Hikaru-Su/uC_easiri/README.md

# uC_easiri
## can通信系エアシリ制御ボード
1. 電源が切り離されているため、電磁弁用の電源が必要。
3. 12V時に電磁弁に印加される電流が160mAほどだったため8個同時に動かす場合、1Aを超えるため電源を分けた。<br>

|MCUピン|エアシリ番号|
|---|---|
|pin9|es5|
|pin10|es6|
|pin11|es7|
|pin12|es8|
|pin13|es1|
|pin14|es2|
|pin15|es3|
|pin18|es4|
