Hikaru-Su/uC_easiri/エアシリ部品リスト/エアシリ部品リスト.tex

\documentclass[12pt,a4paper,dvipdfmx]{ujarticle}
\usepackage[top = 20truemm, bottom = 20truemm, left = 15truemm , right = 15truemm]{geometry}
\usepackage[dvipdfmx]{graphicx}
\usepackage{here}
\usepackage[dvipdfmx]{hyperref}
\usepackage{pxjahyper}
\hypersetup{
	bookmarksnumbered = true,
	colorlinks = true,
	setpagesize = false,
	linkcolor = blue,
	urlcolor = blue
}
\title{エアシリ基板部品リスト}
\author{小野澤颯}
\begin{document}
\maketitle
\begin{tabular}{ccccl}
	\hline
	部品名 &必要個数& 買う場所 & 金額 & 備考\\
	\hline
	stdc14pin &1&\href{https://www.digikey.jp/product-detail/ja/samtec-inc/FTSH-107-01-L-D-K/612-FTSH-107-01-L-D-K-ND/6693516}{digi-key}&375&\\
	\hline
	soic8 mcp2562&1& \href{https://www.digikey.jp/product-detail/ja/microchip-technology/MCP2562T-E-SN/MCP2562T-E-SNCT-ND/5011025}{digikey}&101 & rsとかでも買える\\
	\hline
	tlp290 4回路 & 2 & \href{https://jp.rs-online.com/web/p/products/8851083/}{rs}&68.50&\\
	\hline
	tc4011bft &2&\href{https://jp.rs-online.com/web/p/products/6634283/}{rs}&50.40&\\
	\hline
	2sc5964 &1&\href{https://jp.rs-online.com/web/p/products/7740746/}{rs}&42.10&\\
	\hline
	njm11100f1 &1&\href{https://akizukidenshi.com/catalog/g/gI-06655/}{秋月電子通商}&150&\\
	\hline
	12MHz セラロック &1&\href{https://akizukidenshi.com/catalog/g/gP-14322/}{秋月電子通商}&200&\\
	\hline
	表面実装タクトスイッチ&1&\href{https://akizukidenshi.com/catalog/g/gP-14888/}{秋月電子通商}&110&\\
	\hline
	チップled & 8 & \href{https://akizukidenshi.com/catalog/g/gI-11880/}{秋月電子通商}&100 &色はなんでもいい\\
	\hline
	フルカラーled & 1 & \href{https://akizukidenshi.com/catalog/g/gI-12726/}{秋月電子通商}&100 &\\
	\hline
	抵抗内蔵led & 1 & \href{https://akizukidenshi.com/catalog/g/gI-06252/}{秋月電子通商}&200&色はなんでもいい\\
	\hline
	10pinボックスヘッダ & 1 & \href{https://akizukidenshi.com/catalog/g/gC-13178/}{秋月電子通商}&25 &\\
	\hline
	stm32f303k8 &1&\href{https://akizukidenshi.com/catalog/g/gI-10790/}{秋月電子通商}&350&stマイクロから提供してもらってる\\
	\hline
	xhコネクタ2ピン&8& \href{https://akizukidenshi.com/catalog/g/gC-12247/}{秋月電子通商} &10& ハウジング、コンタクトも買う\\
	\hline
	抵抗& & & &\\
	\hline
	1608 10k&10&秋月電子通商 & &大学においてある\\
	\hline
	1608 120&1&秋月電子通商 & &大学においてある\\
	\hline
	集合1k& 3 &売ってる場所不明 & &大学においてある\\
	\hline
	集合10k & 4 & \href{https://akizukidenshi.com/catalog/g/gP-04664/}{秋月電子通商}&100&\\
	\hline
	1608 33k&1& 秋月電子通商 & &大学においてある\\
	\hline
	1608 20k&1& 秋月電子通商 & &大学においてある\\
	\hline
	コンデンサ & & & &特性は気にしなくてもいいかも\\
	\hline
	1608 1u & 1 & \href{https://akizukidenshi.com/catalog/g/gP-14526/}{秋月電子通商}& 100 & \\
	\hline
	1608 0.1u & 7 & \href{https://akizukidenshi.com/catalog/g/gP-13374/}{秋月電子通商}& 100 & \\
	\hline
	1608 4.7u & 2 & \href{https://akizukidenshi.com/catalog/g/gP-09218/}{秋月電子通商}& 200 & \\
	\hline
	1608 10u & 1 & \href{https://akizukidenshi.com/catalog/g/gP-13336/}{秋月電子通商}& 100 & \\
	\hline
	1608 0.22u & 1 & \href{https://akizukidenshi.com/catalog/g/gP-14574/}{秋月電子通商}& 110 & \\
	\hline
	1608 470p & 1 & \href{https://akizukidenshi.com/catalog/g/gP-09268/}{秋月電子通商}& 180 & \\
	\hline
	電解コンデンサ 330u &1&\href{https://akizukidenshi.com/catalog/g/gP-04648/}{秋月電子通商}&100&\\
	\hline
\end{tabular}

\end{document}
