Hikaru-Su/uC_easiri/エアシリ部品リスト/エアシリ部品リスト.pdf

# エアシリ基板部品リスト

### 小野澤颯

2020 年 11 月 24 日

部品名 | 必要個数 | 買う場所 | 金額 備考
stdc14pin | 1 | digi-key (https://www.digikey.jp/product-detail/ja/samtec-inc/FTSH-107-01-L-D-K/612-FTSH-107-01-L-D-K-ND/6693516) | 375
soic8 mcp2562 | 1 | digikey (https://www.digikey.jp/product-detail/ja/microchip-technology/MCP2562T-E-SN/MCP2562T-E-SNCT-ND/5011025) | 101 | rs とかでも買える
tlp290 4 回路 | 2 | rs (https://jp.rs-online.com/web/p/products/8851083/) | 68.50
tc4011bft | 2 | rs (https://jp.rs-online.com/web/p/products/6634283/) | 50.40
2sc5964 | 1 | rs (https://jp.rs-online.com/web/p/products/7740746/) | 42.10
njm11100f1 | 1 | 秋月電子通商 (https://akizukidenshi.com/catalog/g/gI-06655/) | 150
12MHz セラロック | 1 | 秋月電子通商 (https://akizukidenshi.com/catalog/g/gP-14322/) | 200
表面実装タクトスイッチ | 1 | 秋月電子通商 (https://akizukidenshi.com/catalog/g/gP-14888/) | 110
チップ led | 8 | 秋月電子通商 (https://akizukidenshi.com/catalog/g/gI-11880/) | 100 | 色はなんでもいい
フルカラー led | 1 | 秋月電子通商 (https://akizukidenshi.com/catalog/g/gI-12726/) | 100
抵抗内蔵 led | 1 | 秋月電子通商 (https://akizukidenshi.com/catalog/g/gI-06252/) | 200 | 色はなんでもいい
10pin ボックスヘッダ | 1 | 秋月電子通商 (https://akizukidenshi.com/catalog/g/gC-13178/) | 25
stm32f303k8 | 1 | 秋月電子通商 (https://akizukidenshi.com/catalog/g/gI-10790/) | 350 | st マイクロから提供してもらってる
xh コネクタ 2 ピン | 8 | 秋月電子通商 (https://akizukidenshi.com/catalog/g/gC-12247/) | 10 | ハウジング、コンタクトも買う
抵抗
1608 10k | 10 | 秋月電子通商 | | 大学においてある
1608 120 | 1 | 秋月電子通商 | | 大学においてある
集合 1k | 3 | 売ってる場所不明 | | 大学においてある
集合 10k | 4 | 秋月電子通商 (https://akizukidenshi.com/catalog/g/gP-04664/) | 100
1608 33k | 1 | 秋月電子通商 | | 大学においてある
1608 20k | 1 | 秋月電子通商 | | 大学においてある
コンデンサ | | | | 特性は気にしなくてもいいかも
1608 1u | 1 | 秋月電子通商 (https://akizukidenshi.com/catalog/g/gP-14526/) | 100
1608 0.1u | 7 | 秋月電子通商 (https://akizukidenshi.com/catalog/g/gP-13374/) | 100
1608 4.7u | 2 | 秋月電子通商 (https://akizukidenshi.com/catalog/g/gP-09218/) | 200
1608 10u | 1 | 秋月電子通商 (https://akizukidenshi.com/catalog/g/gP-13336/) | 100
1608 0.22u | 1 | 秋月電子通商 (https://akizukidenshi.com/catalog/g/gP-14574/) | 110
1608 470p | 1 | 秋月電子通商 (https://akizukidenshi.com/catalog/g/gP-09268/) | 180
電解コンデンサ 330u | 1 | 秋月電子通商 (https://akizukidenshi.com/catalog/g/gP-04648/) | 100

1
