Hikaru-Su/uC_easiri/easiri/easiri.brd

## EAGLE design easiri/easiri.brd (2021-11-09)

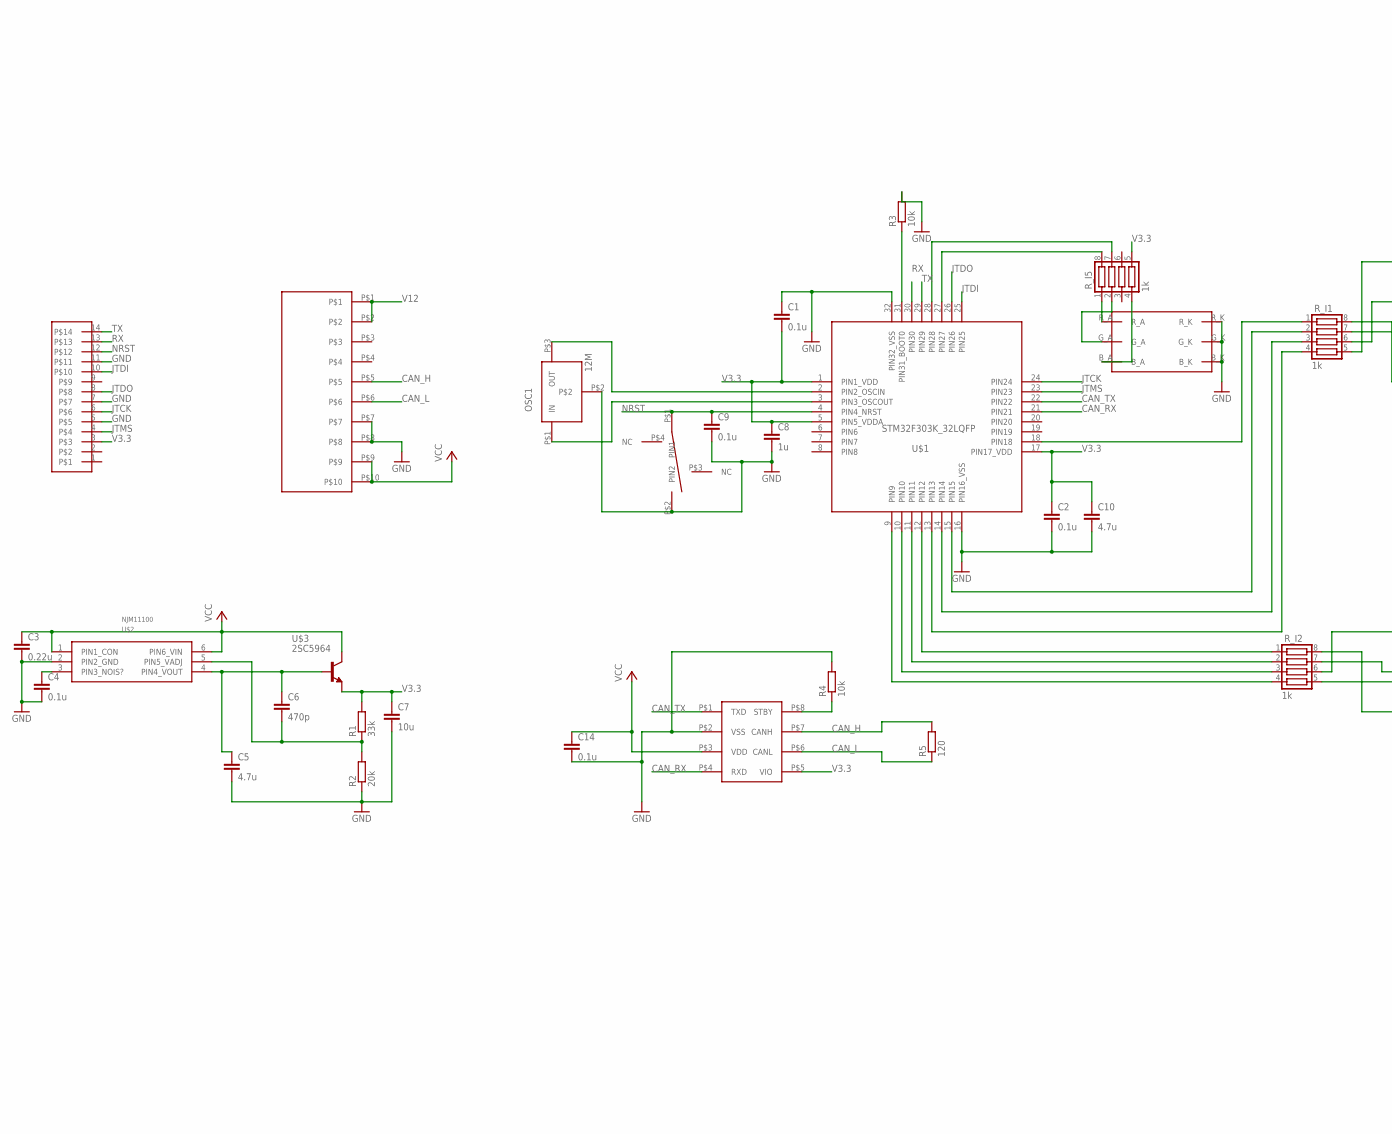
[picture p1: schematic easiri.sch, part in row 1, column 1]

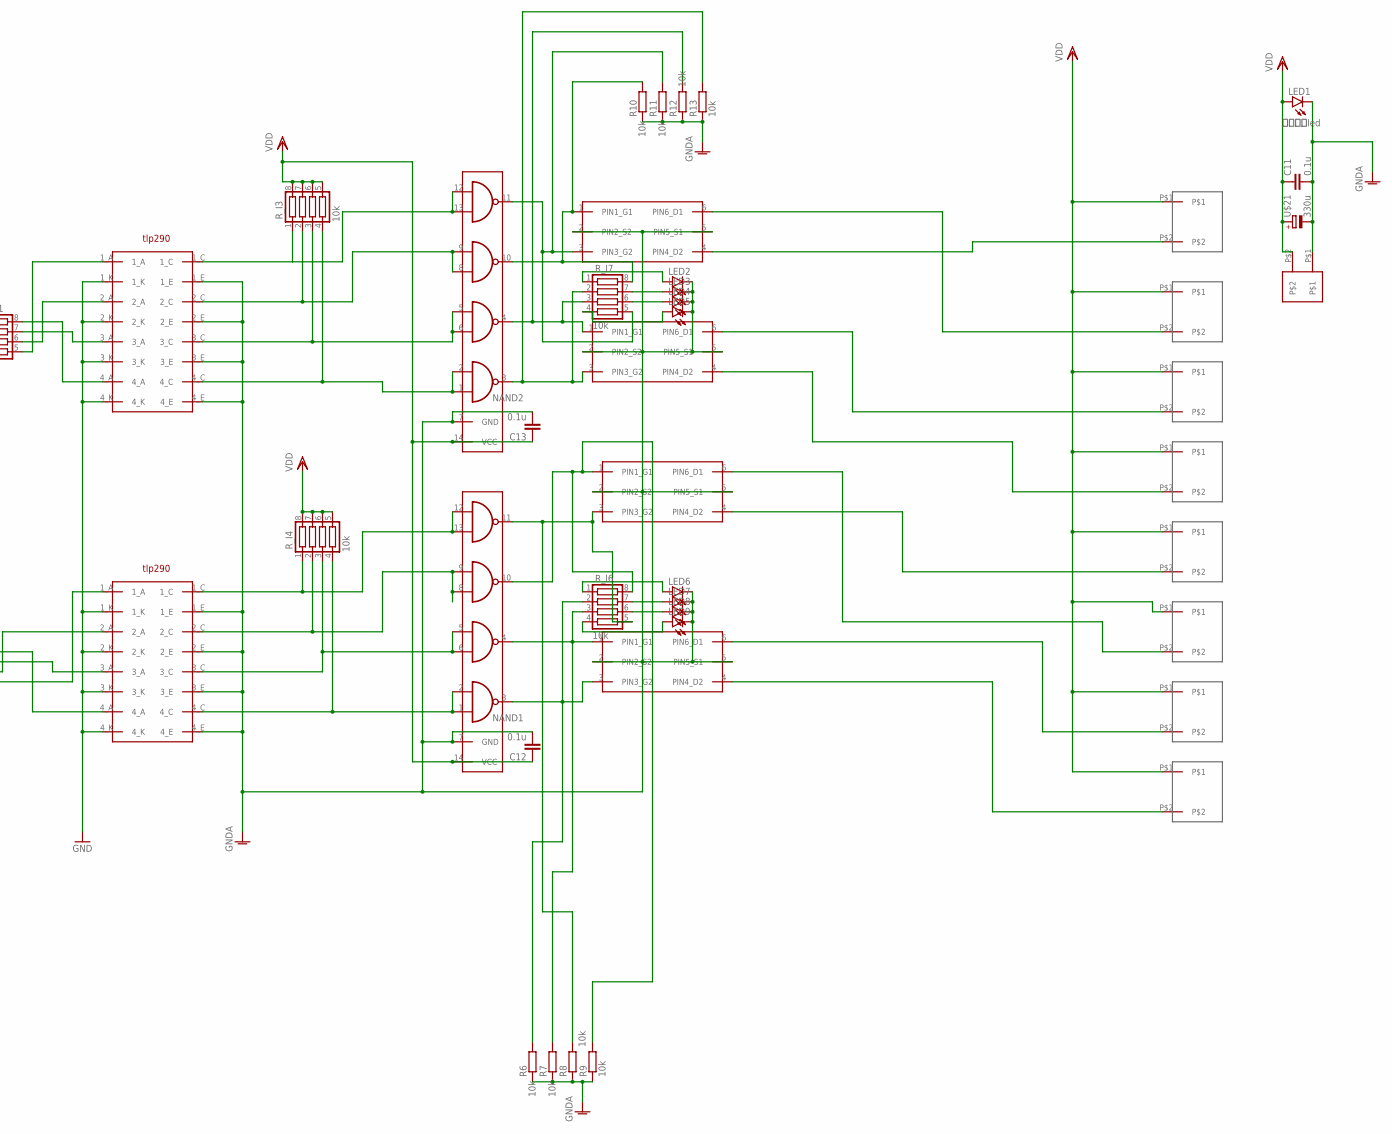
[picture p2: schematic easiri.sch, part in row 1, column 2]

Parts:
BOX10P-L2: BOX10PBOX10P-L; BOX10P-L
C1, C2, C4, C9, C11, C12, C13, C14: 0.1u; C1608
C3: 0.22u; C2012
C5, C10: 4.7u; C2012
C6: 470p; C1608
C7: 10u; C2012
C8: 1u; C1608
ES1, ES2, ES3, ES4, ES5, ES6, ES7, ES8: XH_2P
LED1: 抵抗内蔵led; LED5MM
LED2, LED3, LED4, LED5, LED6, LED7, LED8, LED9: 1608LED; 1608
NAND1, NAND2: 14PIN_NAND2; TSSOP14
OSC1: 12M; CSTNE#
R1: 33k; 1608
R2: 20k; 1608
R3, R4, R6, R7, R8, R9, R10, R11, R12, R13: 10k; 1608
R5: 120; 1608
R_I1, R_I2, R_I5: 1k; 0603X4RESISTOR
R_I3, R_I4, R_I6, R_I7: 10k; 1005X4RESISTOR
U$1: STM32F303K_32LQFP; LQFP32-7X7
U$2: NJM11100; SOT23-6
U$3: 2SC5964; PCP
U$4: TAKUTOSUITTI2
U$5: MCP2562MCP2561-SN; SOIC8
U$6, U$7: TLP290-4; TLP290
U$8, U$9, U$10, U$11: SSOT6_FET; SSOT6
U$12: YUROBLOCK2
U$21: 330u; 1014CAPA
U$22: BOX14P; CON_HEDA14P_1.27
U$23: RGB_LED

Connections:
CAN_H: BOX10P-L2.P$5, R5.2, U$5.P$7 (CANH)
CAN_L: BOX10P-L2.P$6, R5.1, U$5.P$6 (CANL)
CAN_RX: U$1.21 (PIN21), U$5.P$4 (RXD)
CAN_TX: U$1.22 (PIN22), U$5.P$1 (TXD)
GND: BOX10P-L2.P$7, BOX10P-L2.P$8, C1.1, C2.2, C3.2, C4.2, C5.2, C7.2, C8.2, C9.2, C10.2, C14.2, OSC1.P$2, R2.1, R3.2, R4.2, U$1.16 (PIN16_VSS), U$1.32 (PIN32_VSS), U$2.2 (PIN2_GND), U$4.P$2 (PIN2), U$5.P$2 (VSS), U$6.1_K, U$6.2_K, U$6.3_K, U$6.4_K, U$7.1_K, U$7.2_K, U$7.3_K, U$7.4_K, U$22.5, U$22.7, U$22.11, U$23.B_K, U$23.G_K, U$23.R_K
GNDA: C11.2, C12.2, C13.2, LED1.K (C), LED2.K, LED3.K, LED4.K, LED5.K, LED6.K, LED7.K, LED8.K, LED9.K, NAND1.7 (GND), NAND2.7 (GND), R6.1, R7.1, R8.1, R9.1, R10.1, R11.1, R12.1, R13.1, U$6.1_E, U$6.2_E, U$6.3_E, U$6.4_E, U$7.1_E, U$7.2_E, U$7.3_E, U$7.4_E, U$8.2 (PIN2_S2), U$8.5 (PIN5_S1), U$9.2 (PIN2_S2), U$9.5 (PIN5_S1), U$10.2 (PIN2_S2), U$10.5 (PIN5_S1), U$11.2 (PIN2_S2), U$11.5 (PIN5_S1), U$12.P$1, U$21.-
JTCK: U$1.24 (PIN24), U$22.6
JTDI: U$1.25 (PIN25), U$22.10
JTDO: U$1.26 (PIN26), U$22.8
JTMS: U$1.23 (PIN23), U$22.4
unnamed: C6.2, R1.1, R2.2, U$2.5 (PIN5_VADJ)
unnamed: C4.1, U$2.3 (PIN3_NOIS?)
unnamed: C5.1, C6.1, U$2.4 (PIN4_VOUT), U$3.1 (B)
unnamed: OSC1.P$1 (IN), U$1.3 (PIN3_OSCOUT)
unnamed: OSC1.P$3 (OUT), U$1.2 (PIN2_OSCIN)
unnamed: R3.1, U$1.31 (PIN31_BOOT0)
unnamed: R_I1.8, U$6.4_A
unnamed: R_I1.7, U$6.3_A
unnamed: R4.1, U$5.P$8 (STBY)
unnamed: R_I1.6, U$6.2_A
unnamed: R_I5.8, U$1.27 (PIN27)
unnamed: R_I2.6, U$7.2_A
unnamed: NAND2.12 (4B), NAND2.13 (4A), R_I3.1, U$6.1_C
unnamed: R_I2.7, U$7.3_A
unnamed: R_I2.8, U$7.4_A
unnamed: R_I2.5, U$7.1_A
unnamed: NAND1.5 (2B), NAND1.6 (2A), R_I4.3, U$7.3_C
unnamed: NAND2.5 (2B), NAND2.6 (2A), R_I3.3, U$6.3_C
unnamed: NAND1.1 (1A), NAND1.2 (1B), R_I4.4, U$7.4_C
unnamed: NAND1.3 (1Y), R6.2, R_I6.2, U$11.3 (PIN3_G2)
unnamed: NAND1.8 (3A), NAND1.9 (3B), R_I4.2, U$7.2_C
unnamed: LED8.A, R_I6.6
unnamed: LED7.A, R_I6.7
unnamed: ES3.P$2, U$9.6 (PIN6_D1)
unnamed: ES1.P$2, U$8.4 (PIN4_D2)
unnamed: ES2.P$2, U$8.6 (PIN6_D1)
unnamed: ES4.P$2, U$9.4 (PIN4_D2)
unnamed: LED4.A, R_I7.6
unnamed: ES6.P$2, U$10.6 (PIN6_D1)
unnamed: ES7.P$2, U$11.6 (PIN6_D1)
unnamed: R_I2.1, U$1.12 (PIN12)
unnamed: ES8.P$2, U$11.4 (PIN4_D2)
unnamed: R_I2.2, U$1.11 (PIN11)
unnamed: R_I2.3, U$1.10 (PIN10)
unnamed: R_I2.4, U$1.9 (PIN9)
unnamed: R_I1.4, U$1.13 (PIN13)
unnamed: R_I1.3, U$1.14 (PIN14)
unnamed: R_I1.5, U$6.1_A
unnamed: R_I1.2, U$1.15 (PIN15)
unnamed: R_I5.7, U$1.28 (PIN28)
unnamed: R_I1.1, U$1.18 (PIN18)
unnamed: R_I5.4, U$23.B_A
unnamed: R_I5.1, U$23.R_A
unnamed: R_I5.2, U$23.G_A
unnamed: NAND1.4 (2Y), R7.2, R_I6.3, U$11.1 (PIN1_G1)
unnamed: ES5.P$2, U$10.4 (PIN4_D2)
unnamed: NAND2.8 (3A), NAND2.9 (3B), R_I3.2, U$6.2_C
unnamed: NAND2.1 (1A), NAND2.2 (1B), R_I3.4, U$6.4_C
unnamed: NAND1.12 (4B), NAND1.13 (4A), R_I4.1, U$7.1_C
unnamed: NAND1.10 (3Y), R9.2, R_I6.8, U$10.1 (PIN1_G1)
unnamed: NAND2.3 (1Y), R13.2, R_I7.2, U$9.3 (PIN3_G2)
unnamed: NAND2.4 (2Y), R12.2, R_I7.3, U$9.1 (PIN1_G1)
unnamed: NAND2.10 (3Y), R10.2, R_I7.8, U$8.1 (PIN1_G1)
unnamed: NAND2.11 (4Y), R11.2, R_I7.5, U$8.3 (PIN3_G2)
unnamed: LED9.A, R_I6.4
unnamed: LED6.A, R_I6.1
unnamed: NAND1.11 (4Y), R8.2, R_I6.5, U$10.3 (PIN3_G2)
unnamed: LED3.A, R_I7.7
unnamed: LED5.A, R_I7.4
unnamed: LED2.A, R_I7.1
NRST: C9.1, U$1.4 (PIN4_NRST), U$4.P$1 (PIN1), U$22.12
RX: U$1.30 (PIN30), U$22.13
TX: U$1.29 (PIN29), U$22.14
V3.3: C1.2, C2.1, C7.1, C8.1, C10.1, R1.2, R_I5.5, U$1.1 (PIN1_VDD), U$1.5 (PIN5_VDDA), U$1.17 (PIN17_VDD), U$3.3 (E), U$5.P$5 (VIO), U$22.3
V12: BOX10P-L2.P$1, BOX10P-L2.P$2
VCC: BOX10P-L2.P$9, BOX10P-L2.P$10, C3.1, C14.1, U$2.1 (PIN1_CON), U$2.6 (PIN6_VIN), U$3.2 (C), U$3.2@2 (C), U$5.P$3 (VDD)
VDD: C11.1, C12.1, C13.1, ES1.P$1, ES2.P$1, ES3.P$1, ES4.P$1, ES5.P$1, ES6.P$1, ES7.P$1, ES8.P$1, LED1.A, NAND1.14 (VCC), NAND2.14 (VCC), R_I3.5, R_I3.6, R_I3.7, R_I3.8, R_I4.5, R_I4.6, R_I4.7, R_I4.8, U$12.P$2, U$21.+

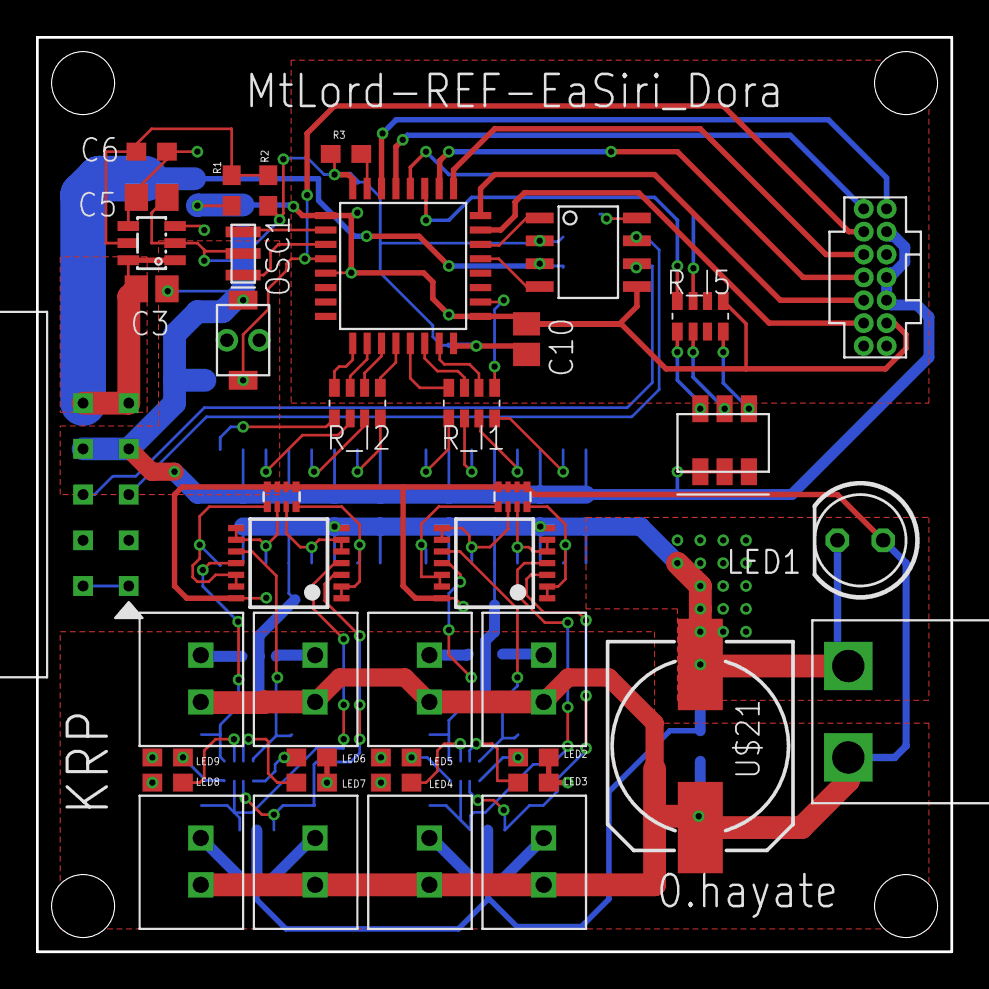
[picture p3: board easiri.brd from above]

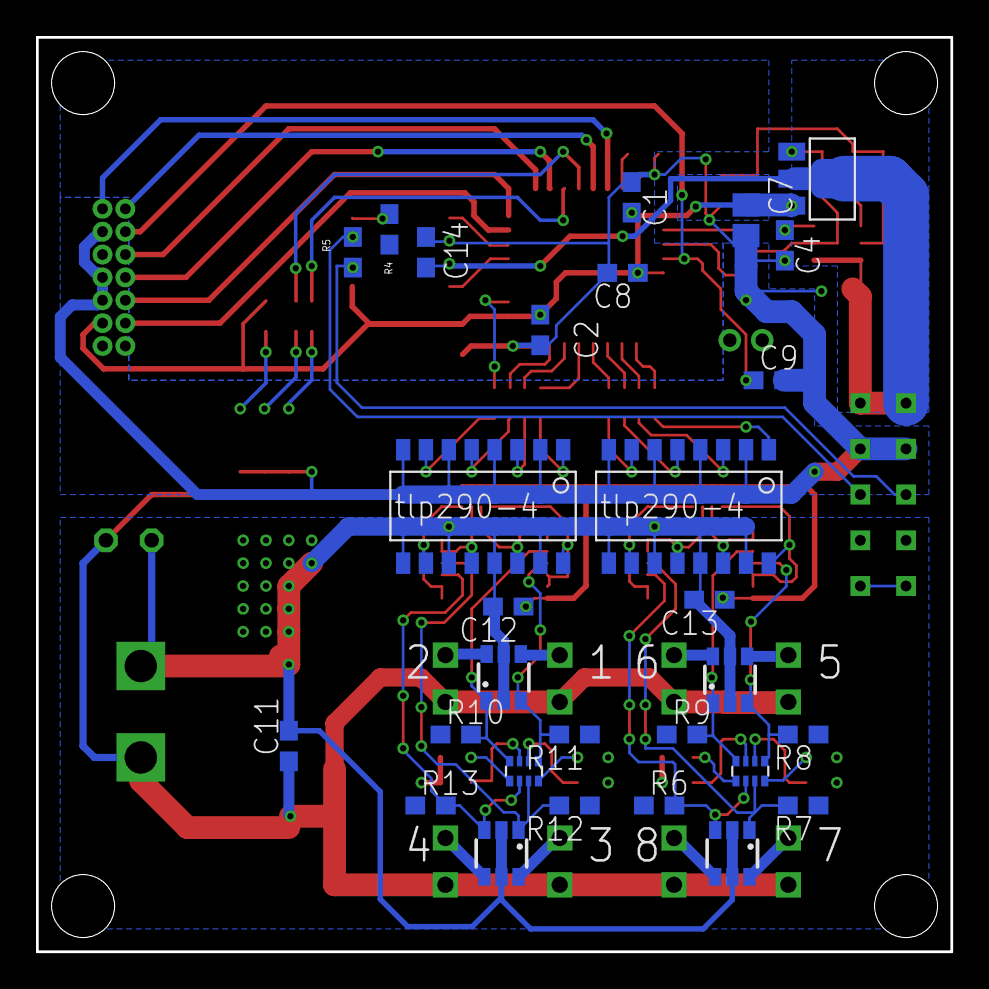
[picture p4: board easiri.brd from below]

Board: 2 copper layers, 50.8 x 50.8 mm, 70 parts (29 on the bottom side), 77 nets.
