Hikaru-Su/uC_easiri/(commit log)

2020-10-22 エアシリンダードライバボウド
    神山先輩のエアシリンダ制御基板を参照及び改良した制御ボード
    電源が切り離されているため、電磁弁用の電源が必要。
    12V時に電磁弁に印加される電流が160mAほどだったため8個同時に動かす場合、1Aを超えるため電源を分けた。
    [easiri.brd, easiri.sch]
2020-10-22 usartとかを追加
    電源確認or通信確認ようledをついか、pcでシリアルモニタによるデバッグができるようにusartを追加
    [easiri.brd, easiri.sch]
2020-10-22 Add files via upload
    canのピンボックスが半分の位置になかったがどうしてもいやだったので半分の位置に来るようにした
    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
    [easiri.brd]
2020-10-23 ロゴの位置を直した
    自己主張大事！！
    [easiri.brd]
2020-10-24 canトランシーバ用のコンデンサを追加
    fet駆動にインバッタをはっさんだ。ゲートにledを入れたがそれがそのままプルダウン抵抗に置き換わるかも
    [easiri.brd, easiri.sch]
2020-10-25 ゲートにプルダウン抵抗を追加
    [easiri.brd, easiri.sch]
2021-11-09 mcp2562スタンバイピンプルダウン
    [easiri.brd, easiri.sch]
